escapetaste/rj45Test_device/additional sockets to test cables.jpg

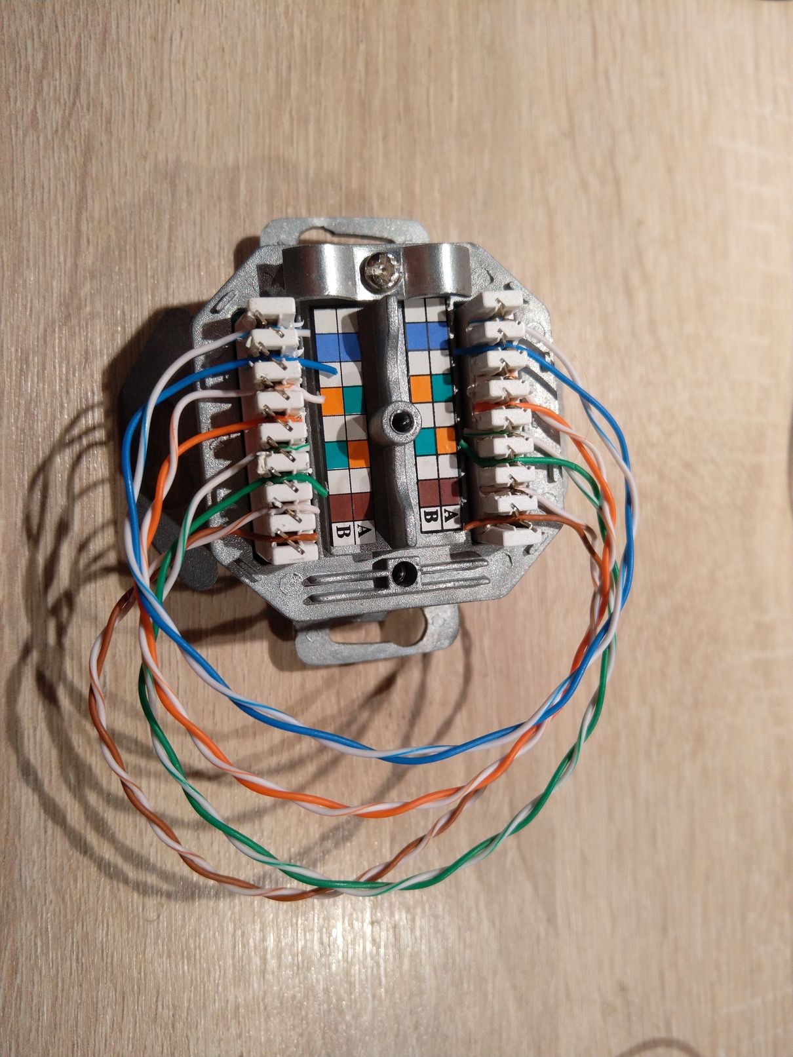
additional sockets to test cables.jpg
