escapetaste/rj45Test_device/reciever.jpg

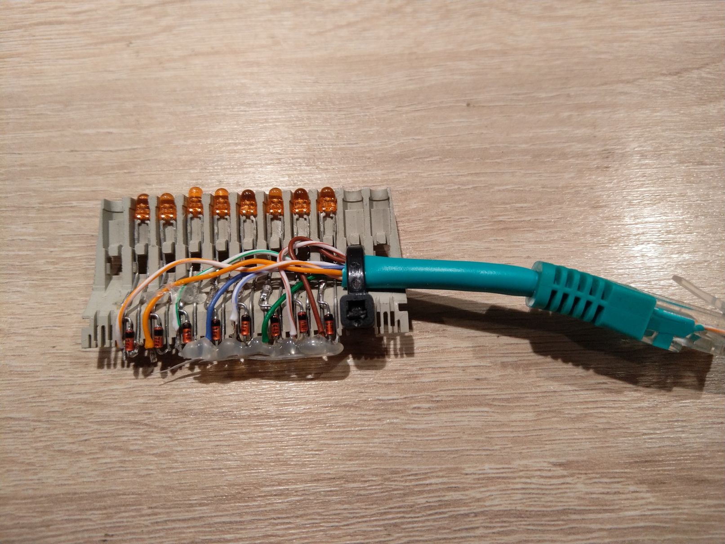
reciever.jpg
