escapetaste/rj45Test_device/sender.jpg

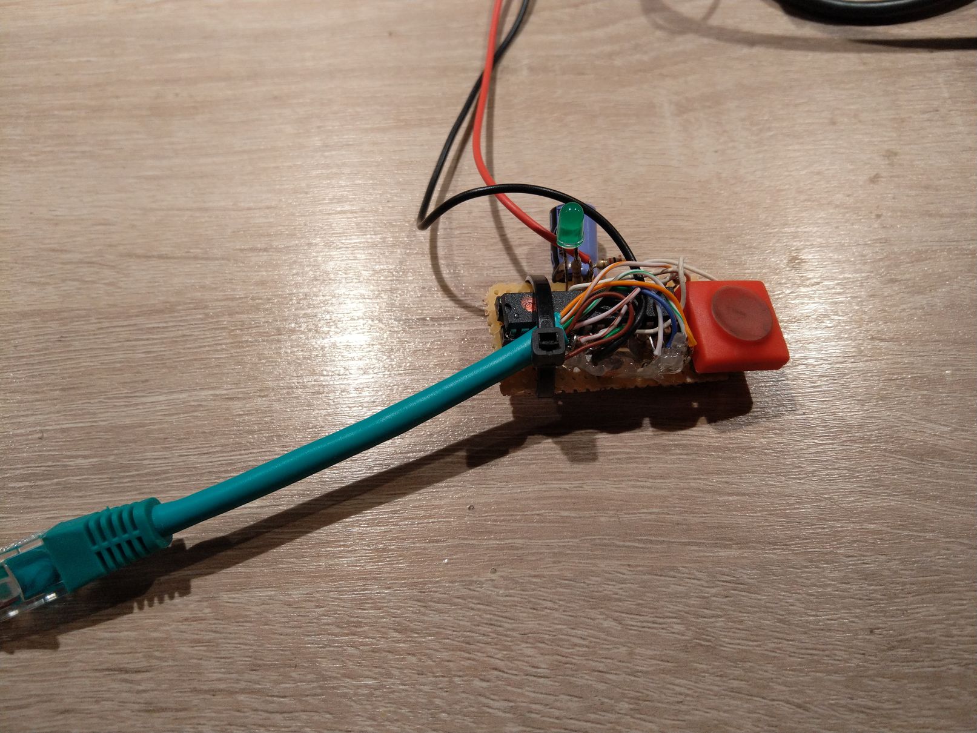
sender.jpg
