escapetaste/rj45Test_device/whole thing.jpg

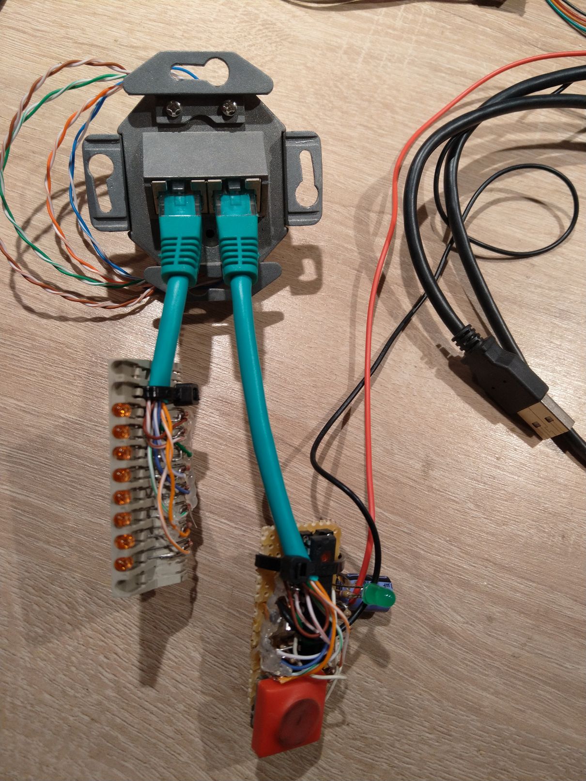
whole thing.jpg
