escapetaste/rj45Test_device/circuit diagram.pdf

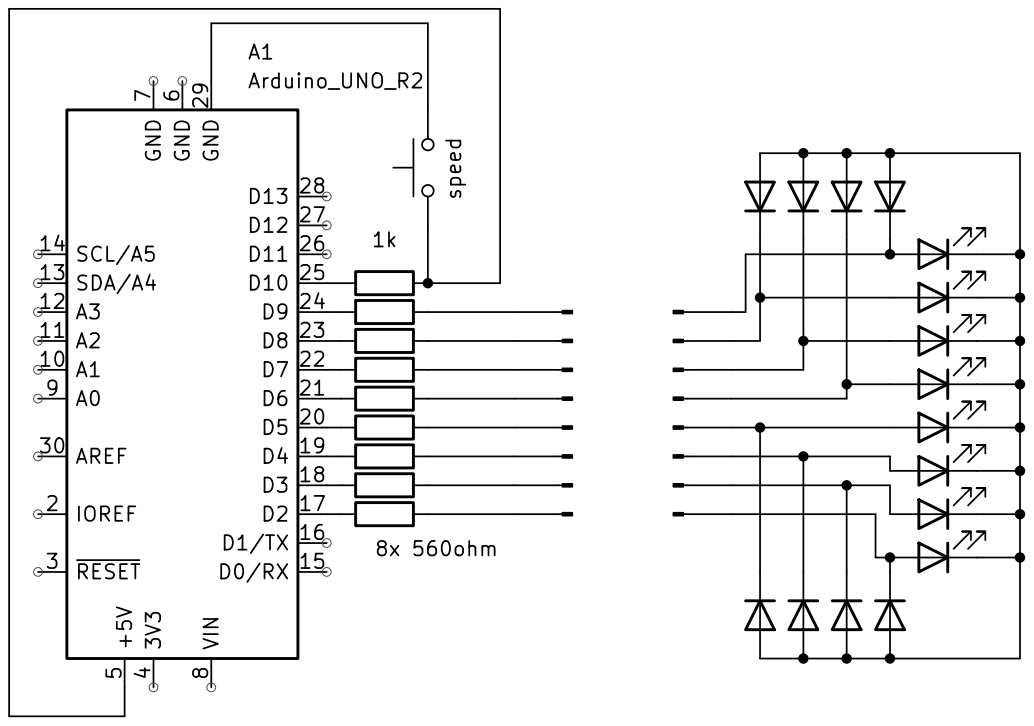
[picture p5: page 1]
